robertprestonjohnson/Physics134-PET/PET_Electronics_V2.pptx

Schematic diagram of the electronics in the blue PET box.
- Back panel: 2 SHV high-voltage connectors, 2 BNC signal connectors, AC receptacle and switch, trailer connector for linear stage.
- Front panel: low and high voltage switches and LEDs, ethernet plug, USB-A plug, DB9 for stop switches, 3 BNC connectors for monitoring by oscilloscope.
- Side panel: DB9 for rotation stage.
- Top panel: pilot light (3.3 V).

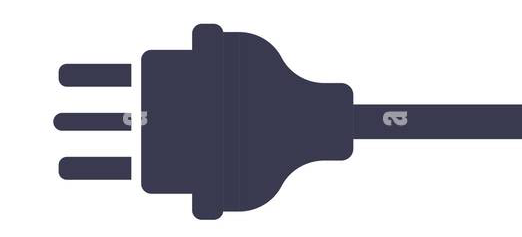
[picture p1: figure]
Electric plug power vector consumption ac symbol icon. Electric plug icon illustration isolated adapter cable connect Stock Vector Image & Art - Alamy

120 V AC
Switch & Fuse

Ethernet to PC

Gen-2 Red Pitaya

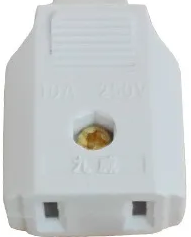
[picture p2: figure]

5 V USB-C supply

Note: the HV wires must be contained within a grounded shield to prevent digital noise from corrupting the detector signals.

120 V AC

GND

24 V DC
Switch

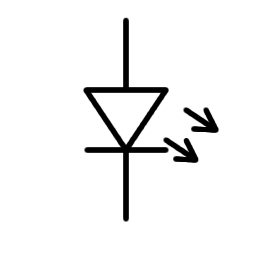
[picture p3: figure]
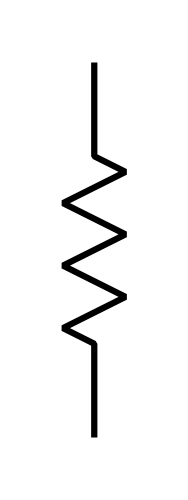
[picture p4: figure]

24 V
DC
Power
Supply

USB-C

2 SHV
Connectors, to PMTs

24 V

24 V DC
Switch

To Linear Stage

Trailer Light Plug

Stepper Motor Controller for Linear Stage

Step
Direction

SMA Cables

E1 Flat Cable

E2 Flat Cable

High Voltage wires

Amplifiers

Coincidence
Circuit

HV

HV

PET Coincidence Board

24 V Power for HV Supplies

RS232 Cable to Rotation Stage

DB9 RS232 Connector

Stepper Motor Controller for Rotation Stage

Step
Direction

24 V

GND

The RP-DIO signal designations come from the Red Pitaya E1 connector, which copy to the E1 connector on the coincidence board and then map onto the E3 connector, into which a twist-flex cable is inserted. Similarly, the TX and RX signals originate from the E2 connector of the Red Pitaya and map onto the twist-flex cable. The coincidence trigger goes to the Red Pitaya external-trigger input via the flat cable to the E1 connector but is also brought out to a BNC connector on the front panel for viewing on an oscilloscope.

RP-DI05_P

RP-DI05_N

3.3 V

USB-A to PC

Adafruit USB-UART Bridge

DB9 RS232 Connector

5 4

2,3

1,6

RS232 cable to stop switches

GND

24 V

12 V switching regulator

CPU fan on Red Pitaya

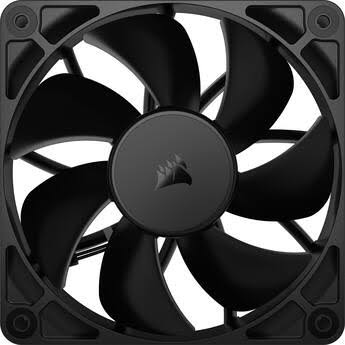
[picture p5: figure]
CORSAIR RS120 120mm PWM Fan

RP-DI07_P

RP-DI04_P

RP-DI04_N

RP-TX

RP-RX

Note: several green wires snake through the box to connect the box panels to ground, because the box construction does not create electrical contacts between the panels.

SMA Cables

RP-DI07_N

12 V

12 V

24 V

RP-DI03_N

BNC Connectors,
from PMT detectors

A, B, Trigger BNC Connectors,
to Oscilloscope

3.3 V

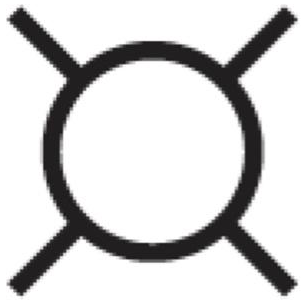
[picture p6: figure]
Solved a 4. What does the ladder diagram symbol shown here | Chegg.com
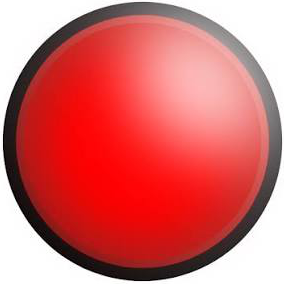
[picture p7: figure]
Pilot Light Symbol | Capital X Panel Designer by Siemens

Pilot Light

RP-DI06_N

GND

Note: the stepper-motor controllers are in principle supposed to be used with 5 V logic, but they always work fine with the 3.3 V logic supplied by the Red Pitaya.

R.P. Johnson
October 13, 2026
