robertprestonjohnson/Physics134-PET/SoftwareDocumentation.docx

# Physics 134 PET Experiment Software Documentation

# 1 Overview

The PET software suite includes code that runs on the Windows-11 PC as well as code that runs under the Linux operating system on the Red Pitaya Generation-2 embedded processor inside of the blue electronics box. The PC code is all written in the Python language, whereas the Red Pitaya code is written in C++. Students should not need to interact directly with the Red Pitaya code. Instead, they normally will interact with a python-coded GUI on the PC. The python code communicates with the Red Pitaya C++ code over a USB cable via the simple UART protocol. It is very slow compared with the full capabilities of USB-3, but it is fast enough for this purpose.

# 2 Github repository

The C++ code, Python code, documentation, student manual, and electronics design files are all archived in Github: https://github.com/robertprestonjohnson/Physics134-PET.

# 3 Red Pitaya C++ Code

The Red Pitaya code interacts with the PET hardware, including the gamma-ray detectors, DACs for setting thresholds and high-voltage, timing chips for setting the coincidence window, and the linear and rotation stages. The C++ code is edited and maintained on the PC in the ???\PET_RP folder. It is copied to the Red Pitaya using the secure file transfer protocol, where it is stored in the folder ???/PET_RP.

There are two main programs, which can be executed from the Linux command line, although only one of them can be used at a time. First, one must log into the Red Pitaya over the Ethernet connection from the PC. Then one can work in a Linux window on the PC web browser. This is meant to be for experts only, for maintenance and testing, not for students in general.

There are two methods for logging into the Red Pitaya. The internet connection details can be found on a sticker on the blue electronics box in case you forget. The first method is to open the web page[^1] ???. A screen will appear with a bunch of widgets. Probably on the second page of widgets will be one named ???. Click on it, and the Linux terminal will open. The second method bypasses the pages of widgets by entering the URL ??? in the PC web browser.

Using the PC line-command window ???, and assuming that you are in the folder ???PET_RP, you can copy files to and from the Red Pitaya as in the following two scp examples

Dd

dd

The PET_RP_Slave program normally starts executing in the background automatically when the Red Pitaya powers on. In that case, if one desires to run the PET_RP program, the PET_RP_Slave process must first be killed. Find the process ID from “ps -u”, and then type “kill <process-ID>”.

The first main program is PET_RP. It can be built by entering “make PET_RP” (it may be necessary first to enter “touch PET_RP.cpp” so that the system thinks that it was altered). This program is meant to be executed manually by whoever is logged into the Red Pitaya, so that it is really only for experts. It follows Linux syntax for its many command-line options. Enter “./PET_RP -h” to get it to write out its lists of commands and options. Here are a few examples:

- ./PET_RP moveStage -d “right” -x 26 (move the linear stage to the right by 26 mm)
- ./PET_RP setDAC -D 1 -v 140 (set the threshold DAC for channel A to 140 mV)
- ./PET_RP setTiming 32 37 (set the channel A and channel B pulse widths the determine the coincidence window)
- ./PET_RP rotateStage -o forward -g 35 (rotate the stage forward by 35 degrees)
- ./PET_RP acquireData -n 1000 -t “internal” -c “chB” (acquire 1000 events on Channel B using the internal trigger)

The main program in PET_RP is very simple. It creates an instance of the PET class (see below) and then calls the method parseCMD to parse the command line and execute the specified function.

The second main program is PET_RP_Slave. It is normally run in the background, e.g. “./PET_RP_Slave &”, where it runs in an infinite loop waiting for commands to come over the UART from the PC. The commands have the same format and options as the ./PET_RP program, but they must be issued from the PC via a python script or from the python-based GUI. The latter should be the normal way for students to work with the system.

Both main programs make use of the same C++ class defined in PET.h and PET.cpp. That class defines all the commands and command options by way of a class arg.h/arg.cpp, which was downloaded from the internet. All of the other code, including the PET class, was custom written for this experiment.

# 3.1 PET_RP_Slave

This main program has only two options:

- verbose (to get lots of printout to the terminal---default is not verbose)
- timeout (an integer to set the length of the UART time-out in seconds---defaults to 10)

In most cases the defaults will be appropriate.

After parsing the optional arguments, the code creates an instance of the PET class and sets up a UART connection for communicating with the PC. It then goes into an infinite loop. In each loop iteration it tries to read from the UART. If it times out before receiving something, then it just goes into the next iteration of the loop. If the string “CLOSE” is received, it will exit the loop and terminate the program after sending back the string “Goodbye!”.

If the string “R U THERE” is received, the program sends back “YES I AM” and then goes to the next iteration of the loop. If the string “START” is received, then it goes into an embedded loop to read the tokens of a command. The tokens are stored in array Argv, and the count Argc of tokens is incremented accordingly. The string “END” will terminate the input of tokens by exiting the loop. Then Argv and Argc are submitted to the parseCMD method of the PET class to be parsed and executed. The command execution blocks until the command action is completed and the program exits from parseCMD. The main program then sends the string “DONE” back to the PC via the UART.

# 3.2 PET Class

The PET class includes the methods parseCMD and histo in PET.cpp, several short methods in PET.h, plus all the following files:

- dacLoad.cpp (to set the 4 DACs on the PET coincidence board, and read them back for verification)
- setTiming.cpp (to load the registers of the timing chips that set the pulse widths of the signals used for the coincidence, to define the coincidence window)
- stepperLeftRight.cpp (generates the signals to control the stepper motor that drives the linear stage, and monitor the two optical stop switches that prevent the stage from hitting the ends of its travel)
- stepperRotate.cpp (generates the signals to control the stepper motor the drives the rotation stage)
- acquireData.cpp (sets up the trigger for data acquisition and then acquires data from a set number of triggers or acquires data from all triggeres over a set period of time)
- linearScan.cpp (executes an entire data taking sequence by scanning the linear stage for a set number of different angles of the rotation stage, taking data at each location by calling acquireData)

The constructor sets up all the command definitions, using the “arg” class. For each command there is a one-letter abbreviation of the name, a full name, a pointer to a variable (generally within a structure defined in PET.h) to hold the value, the type of variable, and a help string. It also allocates memory for histograms, and it initialized the Red Pitaya API. The destructor just releases memory and calls the Red Pitaya API release method.

A short, private method in PET.h, called UARTmsg is used by the various methods to send messages back to the PC. The messages are used by the GUI in various ways:

- If the message begins with “STATUS:”, then the GUI simply displays the message on its status bar.
- If the message begins with “PULSES:”, then the GUI expects it to contain a set of pulse heights to be displayed in a plot of signal versus time for each of the two channels.
- If the message begins with “ERROR:”, then the GUI displays it as an error message.
- If the message begins with “ANALYSIS”, then the contents are expected to be the final PET scan results that will go into the image analysis.
- If the message begins with “SCANDATA”, then its contents are expected to be a line to be saved in the file used to plot counts versus distance on the GUI display.
- If the message begins with “HISTOGRAM”, then its contents are used to plot the spectral histograms for the two channels.

# 3.2.1 parseCMD

The args method of the arg parser class is used to obtain the single position-sensitive argument in the command, which is the action to be taken. Then a set of IF statements call the appropriate method for the specified action. The values of the optional arguments are usually passed to the method (for historical reasons), but they can also be accessed directly by any method in the PET class. The commands are as follows:

- “setTiming”: call PET::setTiming
- “setTHR”: call PET::dacLoad for DAC 1 or 2
- “setHV”: call PET::dacLoad for DAC 3 or 4
- “moveStage”: call PET::stepperLeftRight
- “rotateStage”: call PET::stepperRotate
- “acquireData”: call PET::acquireData
- “scan”: call PET::lineScan

# 3.2.2 setTiming

This method sets the register values in the DS1023 chips, each one a programmable delay line, which control the lengths of the two trigger signals, one from Channel A and the other from Channel B. The outputs of the two DS1023 chips go to an AND gate, which forms the trigger coincidence that is then sent to the Red Pitaya to initiate data acquisition when it is set to use its external trigger. The significance of the timing values is that they establish the coincidence window. The narrower the window, the fewer the noise triggers that get through. However, a window that is too narrow relative to timing jitter could give an inefficient trigger. The arguments are

- Channel A value, from 1 to 255 in nanoseconds
- Channel B value, from 1 to 255 in nanoseconds

The DS 1023 chip has its own ad-hoc protocol for loading and reading its 8-bit register, so this routine handles it by bit-banging with a millisecond clock, making use of five Red Pitaya DIO lines:

- DIO1_N output: the clock (CLK)
- DIO1_P output: the latch-enable (LE)
- DIO2_N output: the output enable (OE)
- DIO2_P output: the data (D) to be shifted in serially
- DIO3_P input: verification data (Q) to be shifted out serially

The channel A and B settings, each 8 bits, are loaded sequentially into a single 16-bit word, CLK is initialized low, and OE and LE are initialized high. Then, a loop over 16 clock cycles loads the two registers, which are daisy-chained on the PC board. For each loop iteration it sets the D pin to the next bit to be shifted in, it then waits for a 20 microsecond setup time (using the usleep() function) before raising the CLK high. After another 480 microseconds it lower CLK. On the 15th iteration it lowers LE at this point, to latch the register contents into the final register that controls the delay line (see the DS1023 datasheet). Then it waits 500 microseconds before going to the next iteration.

After a millisecond wait, the routine reads the 16-bit register twice with the OE pin set low and LE set high. This causes the bits shifted out to be shifted back into the register, so that the read is non-destructive.[^2] The verification is done twice just to make sure that the read really was non-destructive. During these verification cycles, for each clock-period iteration, it reads the Q value, waits 20 microseconds before raising CLK, then waits 480 microseconds before lowering CLK again and, on the 15th iteration, lowering LE. Then it waits 500 microseconds before moving to the next clock iteration. If either of the two iterations fail to match the input setting, then an error flag is set. If everything matches, then a message is sent back to the PC that the load was successful.

# 4 PC Python data acquisition Code and gui

# 5 PC code for image reconstruction

[^1] For this to function, the PC and Red Pitaya should be on the same local network, e.g. with Ethernet cables plugged into the same local router. In principle it could also be made to work with the Red Pitaya cable plugged directly into the PC, but we have not tried that.
[^2] The non-destructive read probably isn’t necessary, in retrospect, as long as LE is not lowered again, because the input register contents were latched into a separate register when LE was lowered.
