robertprestonjohnson/Physics134-PET/(list of files, drawings)

Other design files:
PET_LAB_PCB_Rev3.eprj
PMT_SignalAmp.eprj
