robertprestonjohnson/Physics134-PET/stepperLeftRight.cpp

// Red Pitaya PET API for moving the linear stage left or right a specified distance
// Set a large value >> 230.3 mm to drive the stage all the way to its end
//
// Author: Robert P. Johnson   January, 2026
//

#include <stdio.h>
#include <stdlib.h>
#include <math.h>
#include <unistd.h>

#include "PET.h"
#include "rp.h"

int PET::stepperLeftRight (char const* direction, float distance) {
	bool hitEnd = false;
    if (strcmp(direction,"left") == 0 || strcmp(direction,"right") == 0) {
		if (distance > stageTravelMax) {
			distance = stageTravelMax + 0.1;
			snprintf(logmsg, sizeof(logmsg), "stepperLeftRight: moving stage to the %s until it hits the stop\n",direction);
			logger(logmsg);
			hitEnd = true;
		} else {
			snprintf(logmsg, sizeof(logmsg), "stepperLeftRight: moving stage %f mm to the %s\n",distance,direction);
			logger(logmsg);
		}
    } else {
        snprintf(logmsg, sizeof(logmsg), "stepperLeftRight: bad stage direction %s\n",direction);
        logger(logmsg);
        return EXIT_FAILURE;
    }

    // NEMA 23 stepper motor has a standard step angle of 1.8 degrees, for 200 steps per full revolution
    // There is a 10 mm stroke per revolution from the screw of the linear stage
    // The stepper motor controller can have microsteps from 1 to 125 depending on switch settings

    static double microsteps = 8.0;      // Switches 5,6,7,8 are off off on on
    double mmPerStep = 10.0 / (200.0 * microsteps);

    // Drive the stepper motor controller to make one step per millisecond
    // This will give a speed of about 6.25 mm per second or 375 mm per minute
    #define DLY 430 //pulse length in microseconds  (430 shows as 500 microseconds on the oscilloscope)

    int numSteps = floor(distance / mmPerStep);
    #ifdef VERBOSE
        float time = (float)numSteps / 1000.;
        printf("stepperLeftRight: the stage translation will require %d steps in %f seconds.\n", numSteps, time);
    #endif

    // Defining the Red Pitaya digital pins
    rp_dpin_t STEP_PIN = RP_DIO5_P;
    rp_dpin_t DIR_PIN = RP_DIO5_N;
    rp_dpin_t STOPPINR = RP_DIO7_P;
    rp_dpin_t STOPPINL = RP_DIO7_N;

    // Setting Red Pitaya digital pins as inputs and outputs
    rp_DpinSetDirection(STEP_PIN, RP_OUT);
    rp_DpinSetDirection(DIR_PIN, RP_OUT);
    rp_DpinSetDirection(STOPPINL, RP_IN);
    rp_DpinSetDirection(STOPPINR, RP_IN);

    rp_pinState_t left, right;    // States of the two stop pins

    if (strcmp(direction,"left") == 0) {  // Move the stage to the left the specified number of steps
        rp_DpinSetState(DIR_PIN, RP_HIGH);    //sets direction low=right high=left
        rp_DpinGetState(STOPPINR, &right);
        rp_DpinGetState(STOPPINL, &left);
        #ifdef VERBOSE
            printf("stepperLeftRight: stop pin states at beginning of travel: right=%d, left=%d\n", right, left);
        #endif
        if (left == RP_HIGH) {
            double distCovered = numSteps * mmPerStep;
            for (int i=0; i <= numSteps; i++) {             
                rp_DpinSetState(STEP_PIN, RP_HIGH);    
                usleep(DLY);                               // This code creates square pulses of about 1 ms period to drive the stepper
                rp_DpinSetState(STEP_PIN, RP_LOW);
                usleep(DLY);
                rp_DpinGetState(STOPPINL, &left);
                if (left == RP_LOW) {
                    rp_DpinGetState(STOPPINL, &left);
                    if (left == RP_LOW) {   // Check twice to help avoid noise effects
                        distCovered = i * mmPerStep;
                        snprintf(logmsg, sizeof(logmsg), "stepperLeftRight: motion is stopping after %d steps or %.2f mm due to hitting the end of travel.\n", i, distCovered);
                        logger(logmsg);
                        UARTmsg("STATUS: stopping leftward motion after " + to_string(distCovered) + " mm due to hitting the end of travel.\n");
						if (!hitEnd) {
							UARTmsg("STATUS: stage was moved to the left by only " + to_string(distCovered) + " mm.\n");
							return EXIT_FAILURE;  // a faulty stop signal may have registered
						}
                        break;
                    }
                }
            }
            rp_DpinGetState(STOPPINR, &right);
            #ifdef VERBOSE
                printf("stepperLeftRight: stop pin states at end of travel: right=%d, left=%d\n", right, left); 
            #endif              
            UARTmsg("STATUS: stage was moved to the left by " + to_string(distCovered) + " mm.\n");
        } else {
            snprintf(logmsg, sizeof(logmsg), "stepperLeftRight: no motion is possible, as the stage is already at the leftmost limit of travel.\n");
            logger(logmsg);
            return EXIT_FAILURE;
        }
    } else {  // Move the stage to the right the specified number of steps
        rp_DpinSetState(DIR_PIN, RP_LOW);    //sets direction low=right high=left
        rp_DpinGetState(STOPPINR, &right);
        rp_DpinGetState(STOPPINL, &left);
        #ifdef VERBOSE
            printf("stepperLeftRight: stop pin states at beginning of travel: right=%d, left=%d\n", right, left);
        #endif
        if (right == RP_HIGH) {
            double distCovered = numSteps * mmPerStep;
            for (int i = 0; i <= numSteps; i++) {
                rp_DpinSetState(STEP_PIN, RP_HIGH);
                usleep(DLY);
                rp_DpinSetState(STEP_PIN, RP_LOW);
                usleep(DLY);
                rp_DpinGetState(STOPPINR, &right);
                if (right == RP_LOW) {
                    rp_DpinGetState(STOPPINR, &right);
                    if (right == RP_LOW) {    // Check twice to help avoid noise effects
                        distCovered = i * mmPerStep;
                        snprintf(logmsg, sizeof(logmsg), "stepperLeftRight: motion is stopping after %d steps or %.2f mm due to hitting the end of travel.\n", i, distCovered);
                        logger(logmsg);
                        UARTmsg("STATUS: stopping rightward motion after " + to_string(distCovered) + " mm due to hitting the end of travel.\n");
						if (!hitEnd) {
							UARTmsg("STATUS: stage was moved to the right by only " + to_string(distCovered) + " mm.\n");
							return EXIT_FAILURE;  // a faulty stop signal may have registered
						}
                        break;
                    }
                }
            }
            rp_DpinGetState(STOPPINR, &left);
            #ifdef VERBOSE
                printf("stepperLeftRight: stop pin states at end of travel: right=%d, left=%d\n", right, left);
            #endif
            UARTmsg("STATUS: stage was moved to the right by " + to_string(distCovered) + " mm.\n");
        } else {
            snprintf(logmsg, sizeof(logmsg), "stepperLeftRight: no motion is possible, as the stage is already at the rightmost limit of travel.\n");
            logger(logmsg);
            return EXIT_FAILURE;
        }
    }
    return EXIT_SUCCESS;
}
