robertprestonjohnson/Physics134-PET/(commit log)

2026-06-29 The original commit was not the latest files. This corrects that (hopefully)
    [GUI.py, PET.cpp, PET.h, PET_RP.cpp, PET_RP_Slave.cpp, acquireData.cpp, dacLoad.cpp, linearScan.cpp]
2026-06-29 Forgot to include this in the recent commit. This is the current working GUI
2026-10-12 Add files via upload
    Circuit-board design files for the PET scanner.
2026-10-26 Changed the stop switch pullup resistors from 1.5kohm to 374 ohms, to eliminate noise effects.
2026-11-09 Some more changes to address the problem of false stage stops. The scan should now abort if that happens. Also, the stepper code checks the stop signal twice, to try to avoid noise. Updated the heade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
